RedDeliciousApples/picorv-sha256-soc/docs/PERFORMANCE.md

# Performance Measurements

Cycle counts are the primary metric. Time assuming a 10 ns clock period (100 MHz).

## Baseline

Measured with Vivado 2026.1 behavioral simulation on October 20, 2026.

| Measurement | Cycles | Time at 100 MHz |
|---|---:|---:|
| SHA block latency, empty string | 131 | 1.31 us |
| SHA block latency, `abc` | 131 | 1.31 us |
| Reset release to first block write | 57 | 570 ns |
| First block write through start command | 288 | 2.88 us |
| Start command to accelerator busy | 1 | 10 ns |
| Accelerator busy through done | 131 | 1.31 us |
| Accelerator done through final digest store | 257 | 2.57 us |
| First block write through final digest store | 677 | 6.77 us |
| Reset release through final digest store | 734 | 7.34 us |

The accelerator accounts for 131 of the 734 end-to-end cycles.

## Software Baseline

Measured with Vivado 2026.1 behavioral simulation on October 20, 2026. The
firmware uses the string-free C++ SHA-256 implementation, which you can read
more about in [the firmware directory](../firmware/hash-library/).

| Measurement | Cycles | Time at 100 MHz |
|---|---:|---:|
| Reset release to software start marker | 63 | 630 ns |
| Software SHA setup through digest store | 30,108 | 301.08 us |
| Reset release through completion marker | 30,171 | 301.71 us |

The empty-string digest was checked in RAM before the test passed.

## My Definition of Speedup

```text
end-to-end speedup = software.total_cycles / soc.total_cycles
```

For the current measurements:

```text
end-to-end speedup = 30,171 / 734 = 41.10x
end-to-end cycle reduction = 1 - (734 / 30,171) = 97.57%
```

Both testbenches use the same design.

The closest current comparison between software and the SoC is:

```text
operation speedup = software.hash_and_store_cycles / soc.operation_cycles
```

For the current measurements:

```text
operation speedup = 30,108 / 677 = 44.47x
operation cycle reduction = 1 - (677 / 30,108) = 97.75%
```

## Findings

What we (royal we) found is that for this specific PicoRV32 core, specifically the AXI variant, can run SHA-256 operations about 41 times faster
when the algorithm is baked into the hardware. In other words, for this core, and only this core, we made SHA-256 faster.

This does NOT mean:
- You can run SHA-256 faster than current modern CPUs. Much smarter people than me have worked on optimizing that as much as possible. What I did was optimize it specifically on the PicoRV32 software CPU.
- A hypothetical fabbed version of this design would achieve a 41x speedup. While it would still be faster, there's plenty of factors to consider that may make it slower than simulation.
- This is the best result we can get. We could still experiment with parallel processing, multiple cores, pipelining, or many other things.

## Running The Measurements

The block-level, accelerator SoC, and software SoC testbenches output lines beginning with `MEASURE`. You can run all three with:

```text
vivado -mode batch -source tools/run_measurements.tcl \
  -tclargs path/to/picorv.xpr
```
