RedDeliciousApples/picorv-sha256-soc/results/asic/2026-11-03-openlane-sky130-50mhz/metrics.csv

Metric | Value
design__lint_error__count | 0
design__lint_timing_construct__count | 0
design__lint_warning__count | 446
design__inferred_latch__count | 0
design__instance__count | 20426
design__instance__area | 182214
design__instance_unmapped__count | 0
synthesis__check_error__count | 0
design__max_slew_violation__count__corner:nom_tt_025C_1v80 | 0
design__max_fanout_violation__count__corner:nom_tt_025C_1v80 | 0
design__max_cap_violation__count__corner:nom_tt_025C_1v80 | 0
power__internal__total | 0.013605615124106407
power__switching__total | 0.009083560667932034
power__leakage__total | 2.312955871275335E-7
power__total | 0.02268940582871437
clock__skew__worst_hold__corner:nom_tt_025C_1v80 | -0.6070374374986053
clock__skew__worst_setup__corner:nom_tt_025C_1v80 | 0.5434023385072319
timing__hold__ws__corner:nom_tt_025C_1v80 | 0.3098515975943243
timing__setup__ws__corner:nom_tt_025C_1v80 | 9.832071435304139
timing__hold__tns__corner:nom_tt_025C_1v80 | 0.0
timing__setup__tns__corner:nom_tt_025C_1v80 | 0.0
timing__hold__wns__corner:nom_tt_025C_1v80 | 0
timing__setup__wns__corner:nom_tt_025C_1v80 | 0.0
timing__hold_vio__count__corner:nom_tt_025C_1v80 | 0
timing__hold_r2r__ws__corner:nom_tt_025C_1v80 | 0.309852
timing__hold_r2r_vio__count__corner:nom_tt_025C_1v80 | 0
timing__setup_vio__count__corner:nom_tt_025C_1v80 | 0
timing__setup_r2r__ws__corner:nom_tt_025C_1v80 | 13.251459
timing__setup_r2r_vio__count__corner:nom_tt_025C_1v80 | 0
design__max_slew_violation__count__corner:nom_ss_100C_1v60 | 0
design__max_fanout_violation__count__corner:nom_ss_100C_1v60 | 0
design__max_cap_violation__count__corner:nom_ss_100C_1v60 | 0
clock__skew__worst_hold__corner:nom_ss_100C_1v60 | -0.8730536540826954
clock__skew__worst_setup__corner:nom_ss_100C_1v60 | 0.761236983883669
timing__hold__ws__corner:nom_ss_100C_1v60 | 0.849092709065271
timing__setup__ws__corner:nom_ss_100C_1v60 | 4.132765358020845
timing__hold__tns__corner:nom_ss_100C_1v60 | 0.0
timing__setup__tns__corner:nom_ss_100C_1v60 | 0.0
timing__hold__wns__corner:nom_ss_100C_1v60 | 0
timing__setup__wns__corner:nom_ss_100C_1v60 | 0.0
timing__hold_vio__count__corner:nom_ss_100C_1v60 | 0
timing__hold_r2r__ws__corner:nom_ss_100C_1v60 | 0.849093
timing__hold_r2r_vio__count__corner:nom_ss_100C_1v60 | 0
timing__setup_vio__count__corner:nom_ss_100C_1v60 | 0
timing__setup_r2r__ws__corner:nom_ss_100C_1v60 | 6.536827
timing__setup_r2r_vio__count__corner:nom_ss_100C_1v60 | 0
design__max_slew_violation__count__corner:nom_ff_n40C_1v95 | 0
design__max_fanout_violation__count__corner:nom_ff_n40C_1v95 | 0
design__max_cap_violation__count__corner:nom_ff_n40C_1v95 | 0
clock__skew__worst_hold__corner:nom_ff_n40C_1v95 | -0.4935998416377833
clock__skew__worst_setup__corner:nom_ff_n40C_1v95 | 0.44934690573617836
timing__hold__ws__corner:nom_ff_n40C_1v95 | 0.10496903643407901
timing__setup__ws__corner:nom_ff_n40C_1v95 | 11.913857793083066
timing__hold__tns__corner:nom_ff_n40C_1v95 | 0.0
timing__setup__tns__corner:nom_ff_n40C_1v95 | 0.0
timing__hold__wns__corner:nom_ff_n40C_1v95 | 0
timing__setup__wns__corner:nom_ff_n40C_1v95 | 0.0
timing__hold_vio__count__corner:nom_ff_n40C_1v95 | 0
timing__hold_r2r__ws__corner:nom_ff_n40C_1v95 | 0.104969
timing__hold_r2r_vio__count__corner:nom_ff_n40C_1v95 | 0
timing__setup_vio__count__corner:nom_ff_n40C_1v95 | 0
timing__setup_r2r__ws__corner:nom_ff_n40C_1v95 | 15.744382
timing__setup_r2r_vio__count__corner:nom_ff_n40C_1v95 | 0
design__max_slew_violation__count | 0
design__max_fanout_violation__count | 0
design__max_cap_violation__count | 0
clock__skew__worst_hold | -0.48499350352978765
clock__skew__worst_setup | 0.44295068866581055
timing__hold__ws | 0.10309614564971863
timing__setup__ws | 3.913685486464771
timing__hold__tns | 0.0
timing__setup__tns | 0.0
timing__hold__wns | 0
timing__setup__wns | 0.0
timing__hold_vio__count | 0
timing__hold_r2r__ws | 0.103096
timing__hold_r2r_vio__count | 0
timing__setup_vio__count | 0
timing__setup_r2r__ws | 6.283084
timing__setup_r2r_vio__count | 0
design__die__bbox | 0.0 0.0 600.0 600.0
design__core__bbox | 10.12 10.88 589.72 587.52
design__io | 156
design__die__area | 360000
design__core__area | 334221
design__instance__count__stdcell | 20426
design__instance__area__stdcell | 182214
design__instance__count__macros | 0
design__instance__area__macros | 0
design__instance__utilization | 0.545189
design__instance__utilization__stdcell | 0.545189
design__instance__count__class:inverter | 160
design__instance__count__class:sequential_cell | 2280
design__instance__count__class:multi_input_combinational_cell | 8818
flow__warnings__count | 1
flow__errors__count | 0
design__instance__count__class:fill_cell | 20003
design__instance__count__class:tap_cell | 4708
design__power_grid_violation__count__net:VGND | 0
design__power_grid_violation__count__net:VPWR | 0
design__power_grid_violation__count | 0
floorplan__design__io | 154
design__io__hpwl | 13061701
design__max_slew_violation__count__corner:max_ss_100C_1v60 | 0
design__max_fanout_violation__count__corner:max_ss_100C_1v60 | 0
design__max_cap_violation__count__corner:max_ss_100C_1v60 | 0
clock__skew__worst_hold__corner:max_ss_100C_1v60 | -0.8936250881100772
clock__skew__worst_setup__corner:max_ss_100C_1v60 | 0.7699364697060651
timing__hold__ws__corner:max_ss_100C_1v60 | 0.8550222993851918
timing__setup__ws__corner:max_ss_100C_1v60 | 3.913685486464771
timing__hold__tns__corner:max_ss_100C_1v60 | 0.0
timing__setup__tns__corner:max_ss_100C_1v60 | 0.0
timing__hold__wns__corner:max_ss_100C_1v60 | 0
timing__setup__wns__corner:max_ss_100C_1v60 | 0.0
timing__hold_vio__count__corner:max_ss_100C_1v60 | 0
timing__hold_r2r__ws__corner:max_ss_100C_1v60 | 0.855022
timing__hold_r2r_vio__count__corner:max_ss_100C_1v60 | 0
timing__setup_vio__count__corner:max_ss_100C_1v60 | 0
timing__setup_r2r__ws__corner:max_ss_100C_1v60 | 6.283084
timing__setup_r2r_vio__count__corner:max_ss_100C_1v60 | 0
timing__drv__floating__nets | 0
timing__drv__floating__pins | 0
design__instance__displacement__total | 0
design__instance__displacement__mean | 0
design__instance__displacement__max | 0
route__wirelength__estimated | 537720
design__violations | 0
design__instance__count__class:timing_repair_buffer | 3239
design__instance__count__class:clock_buffer | 415
design__instance__count__class:clock_inverter | 210
design__instance__count__setup_buffer | 0
design__instance__count__hold_buffer | 2372
antenna__violating__nets | 13
antenna__violating__pins | 15
route__antenna_violation__count | 13
antenna_diodes_count | 596
design__instance__count__class:antenna_cell | 596
route__net | 14944
route__net__special | 2
route__drc_errors__iter:1 | 8297
route__wirelength__iter:1 | 612678
route__drc_errors__iter:2 | 3533
route__wirelength__iter:2 | 609007
route__drc_errors__iter:3 | 3338
route__wirelength__iter:3 | 607907
route__drc_errors__iter:4 | 244
route__wirelength__iter:4 | 607608
route__drc_errors__iter:5 | 43
route__wirelength__iter:5 | 607630
route__drc_errors__iter:6 | 1
route__wirelength__iter:6 | 607631
route__drc_errors__iter:7 | 0
route__wirelength__iter:7 | 607630
route__drc_errors | 0
route__wirelength | 607630
route__vias | 112318
route__vias__singlecut | 112318
route__vias__multicut | 0
design__disconnected_pin__count | 54
design__critical_disconnected_pin__count | 0
route__wirelength__max | 837.32
timing__unannotated_net__count__corner:nom_tt_025C_1v80 | 350
timing__unannotated_net_filtered__count__corner:nom_tt_025C_1v80 | 0
timing__unannotated_net__count__corner:nom_ss_100C_1v60 | 350
timing__unannotated_net_filtered__count__corner:nom_ss_100C_1v60 | 0
timing__unannotated_net__count__corner:nom_ff_n40C_1v95 | 350
timing__unannotated_net_filtered__count__corner:nom_ff_n40C_1v95 | 0
design__max_slew_violation__count__corner:min_tt_025C_1v80 | 0
design__max_fanout_violation__count__corner:min_tt_025C_1v80 | 0
design__max_cap_violation__count__corner:min_tt_025C_1v80 | 0
clock__skew__worst_hold__corner:min_tt_025C_1v80 | -0.5946043825611047
clock__skew__worst_setup__corner:min_tt_025C_1v80 | 0.5348823757529949
timing__hold__ws__corner:min_tt_025C_1v80 | 0.30654568640040036
timing__setup__ws__corner:min_tt_025C_1v80 | 9.992244647864448
timing__hold__tns__corner:min_tt_025C_1v80 | 0.0
timing__setup__tns__corner:min_tt_025C_1v80 | 0.0
timing__hold__wns__corner:min_tt_025C_1v80 | 0
timing__setup__wns__corner:min_tt_025C_1v80 | 0.0
timing__hold_vio__count__corner:min_tt_025C_1v80 | 0
timing__hold_r2r__ws__corner:min_tt_025C_1v80 | 0.306546
timing__hold_r2r_vio__count__corner:min_tt_025C_1v80 | 0
timing__setup_vio__count__corner:min_tt_025C_1v80 | 0
timing__setup_r2r__ws__corner:min_tt_025C_1v80 | 13.344465
timing__setup_r2r_vio__count__corner:min_tt_025C_1v80 | 0
timing__unannotated_net__count__corner:min_tt_025C_1v80 | 350
timing__unannotated_net_filtered__count__corner:min_tt_025C_1v80 | 0
design__max_slew_violation__count__corner:min_ss_100C_1v60 | 0
design__max_fanout_violation__count__corner:min_ss_100C_1v60 | 0
design__max_cap_violation__count__corner:min_ss_100C_1v60 | 0
clock__skew__worst_hold__corner:min_ss_100C_1v60 | -0.8538241466631302
clock__skew__worst_setup__corner:min_ss_100C_1v60 | 0.7465439588933253
timing__hold__ws__corner:min_ss_100C_1v60 | 0.8430084646736461
timing__setup__ws__corner:min_ss_100C_1v60 | 4.368169949392702
timing__hold__tns__corner:min_ss_100C_1v60 | 0.0
timing__setup__tns__corner:min_ss_100C_1v60 | 0.0
timing__hold__wns__corner:min_ss_100C_1v60 | 0
timing__setup__wns__corner:min_ss_100C_1v60 | 0.0
timing__hold_vio__count__corner:min_ss_100C_1v60 | 0
timing__hold_r2r__ws__corner:min_ss_100C_1v60 | 0.843008
timing__hold_r2r_vio__count__corner:min_ss_100C_1v60 | 0
timing__setup_vio__count__corner:min_ss_100C_1v60 | 0
timing__setup_r2r__ws__corner:min_ss_100C_1v60 | 6.727867
timing__setup_r2r_vio__count__corner:min_ss_100C_1v60 | 0
timing__unannotated_net__count__corner:min_ss_100C_1v60 | 350
timing__unannotated_net_filtered__count__corner:min_ss_100C_1v60 | 0
design__max_slew_violation__count__corner:min_ff_n40C_1v95 | 0
design__max_fanout_violation__count__corner:min_ff_n40C_1v95 | 0
design__max_cap_violation__count__corner:min_ff_n40C_1v95 | 0
clock__skew__worst_hold__corner:min_ff_n40C_1v95 | -0.48499350352978765
clock__skew__worst_setup__corner:min_ff_n40C_1v95 | 0.44295068866581055
timing__hold__ws__corner:min_ff_n40C_1v95 | 0.10309614564971863
timing__setup__ws__corner:min_ff_n40C_1v95 | 12.010248246985551
timing__hold__tns__corner:min_ff_n40C_1v95 | 0.0
timing__setup__tns__corner:min_ff_n40C_1v95 | 0.0
timing__hold__wns__corner:min_ff_n40C_1v95 | 0
timing__setup__wns__corner:min_ff_n40C_1v95 | 0.0
timing__hold_vio__count__corner:min_ff_n40C_1v95 | 0
timing__hold_r2r__ws__corner:min_ff_n40C_1v95 | 0.103096
timing__hold_r2r_vio__count__corner:min_ff_n40C_1v95 | 0
timing__setup_vio__count__corner:min_ff_n40C_1v95 | 0
timing__setup_r2r__ws__corner:min_ff_n40C_1v95 | 15.818834
timing__setup_r2r_vio__count__corner:min_ff_n40C_1v95 | 0
timing__unannotated_net__count__corner:min_ff_n40C_1v95 | 350
timing__unannotated_net_filtered__count__corner:min_ff_n40C_1v95 | 0
design__max_slew_violation__count__corner:max_tt_025C_1v80 | 0
design__max_fanout_violation__count__corner:max_tt_025C_1v80 | 0
design__max_cap_violation__count__corner:max_tt_025C_1v80 | 0
clock__skew__worst_hold__corner:max_tt_025C_1v80 | -0.6190915733070848
clock__skew__worst_setup__corner:max_tt_025C_1v80 | 0.5473912589252219
timing__hold__ws__corner:max_tt_025C_1v80 | 0.3134906867273611
timing__setup__ws__corner:max_tt_025C_1v80 | 9.719284319131841
timing__hold__tns__corner:max_tt_025C_1v80 | 0.0
timing__setup__tns__corner:max_tt_025C_1v80 | 0.0
timing__hold__wns__corner:max_tt_025C_1v80 | 0
timing__setup__wns__corner:max_tt_025C_1v80 | 0.0
timing__hold_vio__count__corner:max_tt_025C_1v80 | 0
timing__hold_r2r__ws__corner:max_tt_025C_1v80 | 0.313491
timing__hold_r2r_vio__count__corner:max_tt_025C_1v80 | 0
timing__setup_vio__count__corner:max_tt_025C_1v80 | 0
timing__setup_r2r__ws__corner:max_tt_025C_1v80 | 13.129471
timing__setup_r2r_vio__count__corner:max_tt_025C_1v80 | 0
timing__unannotated_net__count__corner:max_tt_025C_1v80 | 350
timing__unannotated_net_filtered__count__corner:max_tt_025C_1v80 | 0
timing__unannotated_net__count__corner:max_ss_100C_1v60 | 350
timing__unannotated_net_filtered__count__corner:max_ss_100C_1v60 | 0
design__max_slew_violation__count__corner:max_ff_n40C_1v95 | 0
design__max_fanout_violation__count__corner:max_ff_n40C_1v95 | 0
design__max_cap_violation__count__corner:max_ff_n40C_1v95 | 0
clock__skew__worst_hold__corner:max_ff_n40C_1v95 | -0.5036167181384579
clock__skew__worst_setup__corner:max_ff_n40C_1v95 | 0.4538759496709243
timing__hold__ws__corner:max_ff_n40C_1v95 | 0.10664625040481508
timing__setup__ws__corner:max_ff_n40C_1v95 | 11.840349480454467
timing__hold__tns__corner:max_ff_n40C_1v95 | 0.0
timing__setup__tns__corner:max_ff_n40C_1v95 | 0.0
timing__hold__wns__corner:max_ff_n40C_1v95 | 0
timing__setup__wns__corner:max_ff_n40C_1v95 | 0.0
timing__hold_vio__count__corner:max_ff_n40C_1v95 | 0
timing__hold_r2r__ws__corner:max_ff_n40C_1v95 | 0.106646
timing__hold_r2r_vio__count__corner:max_ff_n40C_1v95 | 0
timing__setup_vio__count__corner:max_ff_n40C_1v95 | 0
timing__setup_r2r__ws__corner:max_ff_n40C_1v95 | 15.650459
timing__setup_r2r_vio__count__corner:max_ff_n40C_1v95 | 0
timing__unannotated_net__count__corner:max_ff_n40C_1v95 | 350
timing__unannotated_net_filtered__count__corner:max_ff_n40C_1v95 | 0
timing__unannotated_net__count | 350
timing__unannotated_net_filtered__count | 0
design_powergrid__voltage__worst__net:VPWR__corner:max_ss_100C_1v60 | 1.59919
design_powergrid__drop__average__net:VPWR__corner:max_ss_100C_1v60 | 1.59978
design_powergrid__drop__worst__net:VPWR__corner:max_ss_100C_1v60 | 0.000811111
design_powergrid__voltage__worst__net:VGND__corner:max_ss_100C_1v60 | 0.00079487
design_powergrid__drop__average__net:VGND__corner:max_ss_100C_1v60 | 0.000222305
design_powergrid__drop__worst__net:VGND__corner:max_ss_100C_1v60 | 0.00079487
design_powergrid__voltage__worst | 0.00079487
design_powergrid__voltage__worst__net:VPWR | 1.59919
design_powergrid__drop__worst | 0.000811111
design_powergrid__drop__worst__net:VPWR | 0.000811111
design_powergrid__voltage__worst__net:VGND | 0.00079487
design_powergrid__drop__worst__net:VGND | 0.00079487
ir__voltage__worst | 1.600000000000000088817841970012523233890533447265625
ir__drop__avg | 0.0002210000000000000050341675272846941879834048449993133544921875
ir__drop__worst | 0.000810999999999999980453135872693337660166434943675994873046875
design__xor_difference__count | 0
magic__drc_error__count | 0
klayout__drc_error__count | 0
magic__illegal_overlap__count | 0
design__lvs_device_difference__count | 0
design__lvs_net_difference__count | 0
design__lvs_property_fail__count | 0
design__lvs_error__count | 0
design__lvs_unmatched_device__count | 0
design__lvs_unmatched_net__count | 0
design__lvs_unmatched_pin__count | 0
