RedDeliciousApples/picorv-sha256-soc/(commit log)

2026-08-04 added more helpful comments instead of ai slop
    [picorv_sha_soc_tb.sv]
2026-08-11 correcting previous commit which didn't include all changed files
    [picorv_sha_soc.sv, picorv_software_sha_tb.sv]
2026-08-22 fail with $fatal, not $finish
    [picorv_sha_soc_tb.sv, sha256_top_tb.sv]
2026-08-22 replace $error with $fatal
    [axi_tb.sv]
2026-09-18 fix ram, make synchronous so vivado can infer it, skip reading .mem file for now
    [axi_lite_ram.sv]
2026-09-21 add reset synchronizer so OpenLane doesn't complain
    [sha256_axi_lite.sv]
2026-09-21 reset should also include working registers a through h
    [sha256_core.sv]
2026-09-22 maybe max wire length will help
2026-11-03 update timing for chained, pipelined core
